dochiphi/solemate/media/photos/branding.png

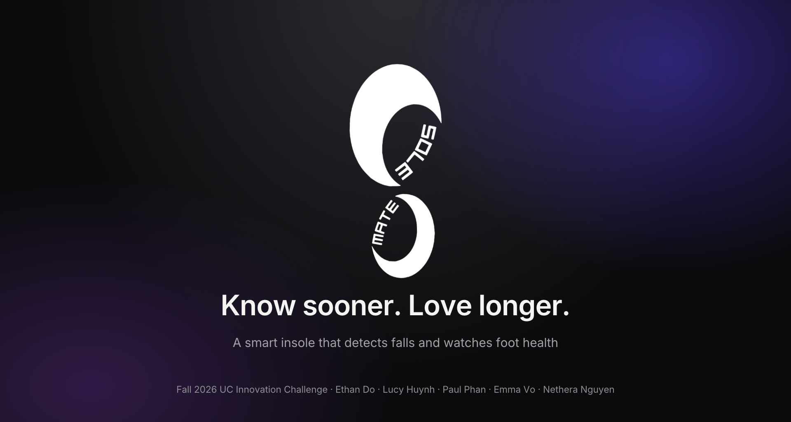
media/photos/branding.png
