dochiphi/solemate/cad/Solemate.SLDASM

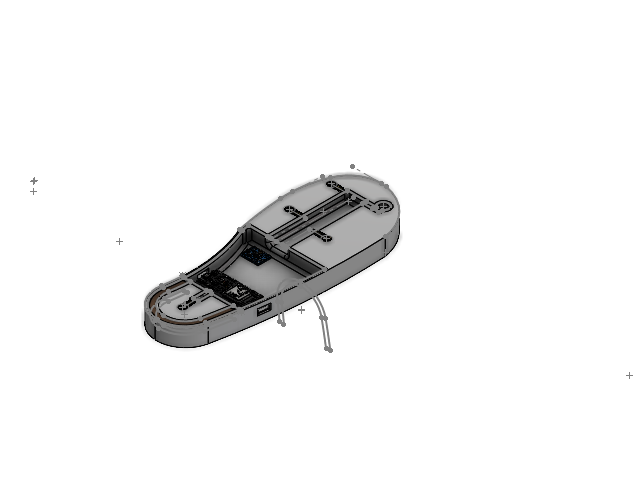
[picture p10: CAD file, 2026-10-19]
cad/Solemate.SLDASM
Solemate
MicroUSB
esp32
AMS1173.3V
cp2102
Push_Bottom x 2
Diodo_K24
Cap_Tam_106
Cap_Tam_106C
Transistor_smd x 2
Led_red_0603
Cap_0603 x 7
Res_102
Res_123 x 3
Res_471 x 4
Res_512 x 2
eBom-FreeParts
Bottom_Substrate x 4
Substrate x 4
GoldProngTerminalofForceSensor x 8
MPU6050
Vibration Motor v1
Magnetic Charging Contact
