dochiphi/solemate/(commit log)

2026-10-19 Revise README for Solemate project details
    Updated project title and expanded README with detailed information about the Solemate prototype, including its purpose, hardware, software, functionality, results, and team roles.
2026-10-19 Change prototype and CAD images to JPEG format
    Updated images in README to use JPEG format instead of PNG.
2026-10-19 Change CAD layout image from JPEG to PNG
    Updated image format for CAD layout in README.
2026-10-19 Update video in README.md
    Replaced quickdemo video with soldering video in README.
2026-11-11 Add dashboard section to README
    Added a section about the dashboard and its prototype link.
2026-11-11 Update print statement from 'Hello' to 'Goodbye'
